jjdegaine/Wifi-Solar-panel-optimizer-/README.md

# Wifi-Solar-panel-optimizer-
Wifi solar panel optimizer
