jjdegaine/Wifi-Solar-panel-optimizer-/photos/electric box.jpg

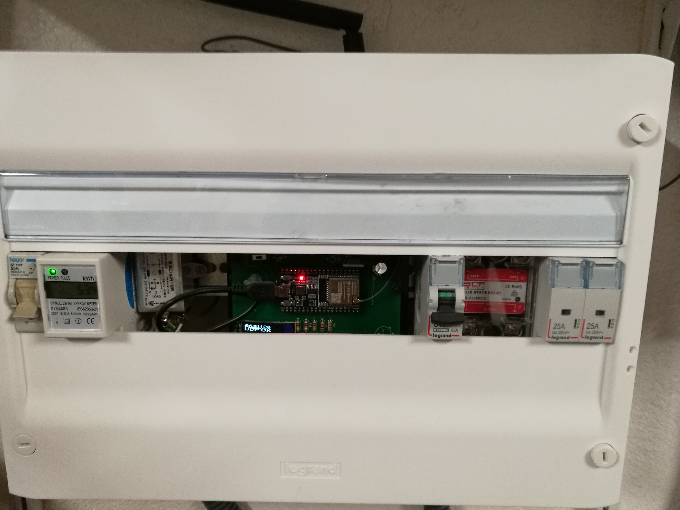
photos/electric box.jpg
