jjdegaine/Wifi-Solar-panel-optimizer-/photos/main board.jpg

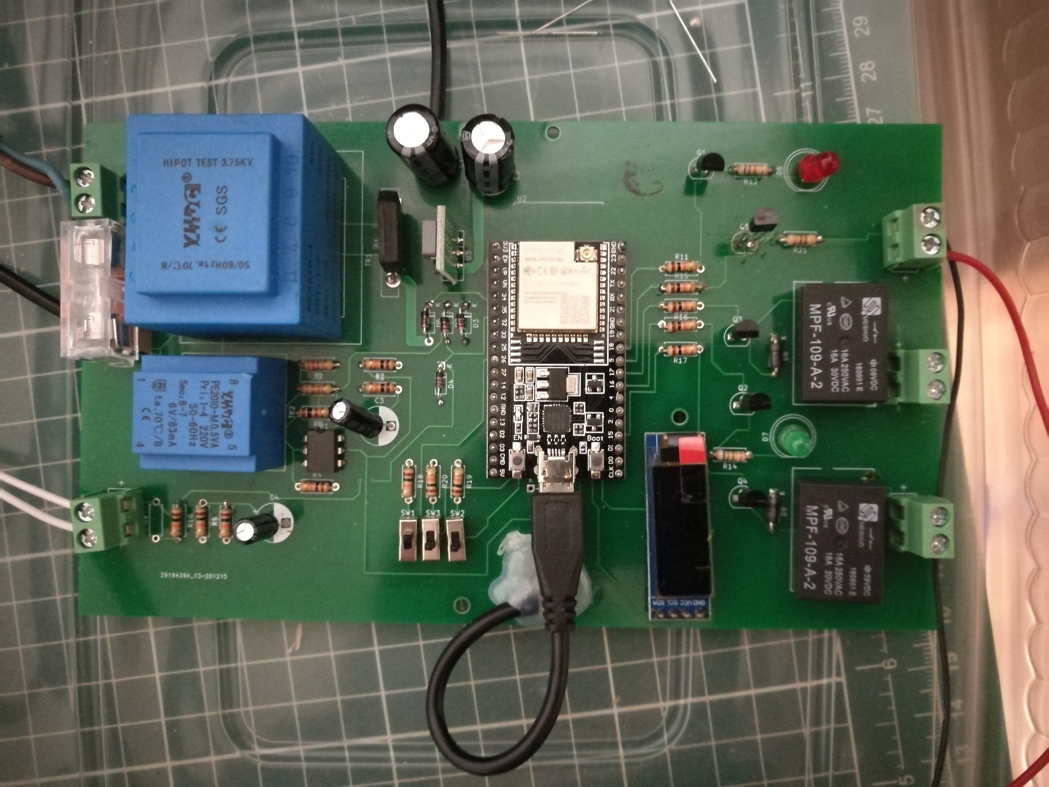
photos/main board.jpg
