jjdegaine/Wifi-Solar-panel-optimizer-/PCB/final version (not tested)/bom.xls

Date: | 19/04/2020 10:00:09
Tool: | Eeschema (5.1.5)-3
Component Count: | 58
Ref | Value | Footprint | Manufacturer
C1 | 1000uF 25V | Capacitor_THT:CP_Radial_D8.0mm_P5.00mm
C2 | 470uF 25V | Capacitor_THT:CP_Radial_D8.0mm_P5.00mm
C3 | 22uF 25V | Capacitor_THT:CP_Radial_D8.0mm_P5.00mm
C4 | 22uF 25V | Capacitor_THT:CP_Radial_D8.0mm_P5.00mm
D1 | GBU4A | Diode_THT:Diode_Bridge_ | https://fr.aliexpress.com/item/32337516440.html?spm=a2g0s.9042311.0.0.27426c37eJJ01N
D2 | 1N4148 | Diode_THT:D_DO-35_SOD27_P7.62mm_Horizontal
D3 | 1N4148 | Diode_THT:D_DO-35_SOD27_P7.62mm_Horizontal
D4 | 1N4148 | Diode_THT:D_DO-35_SOD27_P7.62mm_Horizontal
D5 | 1N4148 | Diode_THT:D_DO-35_SOD27_P7.62mm_Horizontal
D6 | LED RED | LED_THT:LED_D8.0mm
D7 | LED green | LED_THT:LED_D8.0mm
D8 | 1N4148 | Diode_THT:D_DO-35_SOD27_P7.62mm_Horizontal
D9 | 1N4148 | Diode_THT:D_DO-35_SOD27_P7.62mm_Horizontal
D10 | 1N4148 | Diode_THT:D_DO-35_SOD27_P7.62mm_Horizontal
F1 | Fuse | Fuse | https://fr.aliexpress.com/item/32693969111.html?spm=a2g0s.9042311.0.0.27426c37JHMXNt
J1 | Screw_Terminal_01x02 | MKDSN2.5/2-5.08 | https://www.tme.eu/fr/katalog/?search=MKDSN2.5%2F2-5.08&s_field=1000011&s_order=desc
J2 | Screw_Terminal_01x02 | MKDSN2.5/2-5.08 | https://www.tme.eu/fr/katalog/?search=MKDSN2.5%2F2-5.08&s_field=1000011&s_order=desc
J3 | Screw_Terminal_01x02 | MKDSN2.5/2-5.08 | https://www.tme.eu/fr/katalog/?search=MKDSN2.5%2F2-5.08&s_field=1000011&s_order=desc
J4 | Screw_Terminal_01x02 | MKDSN2.5/2-5.08 | https://www.tme.eu/fr/katalog/?search=MKDSN2.5%2F2-5.08&s_field=1000011&s_order=desc
J5 | Screw_Terminal_01x02 | MKDSN2.5/2-5.08 | https://www.tme.eu/fr/katalog/?search=MKDSN2.5%2F2-5.08&s_field=1000011&s_order=desc
J6 | Screw_Terminal_01x02 | MKDSN2.5/2-5.08 | https://www.tme.eu/fr/katalog/?search=MKDSN2.5%2F2-5.08&s_field=1000011&s_order=desc
J7 | Conn_01x04_Male | Connector_PinHeader_2.54mm:PinHeader_1x04_P2.54mm_Vertical
K1 | DIPxx-1Axx-MPF | Relay_THT:Relay_1-MPF109a2 | https://fr.aliexpress.com/item/33000315039.html?spm=a2g0s.9042311.0.0.27426c37eJJ01N
K2 | DIPxx-1Axx-MPF | Relay_THT:Relay_1-MPF109a2 | https://fr.aliexpress.com/item/33000315039.html?spm=a2g0s.9042311.0.0.27426c37eJJ01N
Q1 | Q_NPN_BCE | Package_TO_SOT_THT:TO-92_2n2222
Q2 | Q_NPN_BCE | Package_TO_SOT_THT:TO-92_2n2222
Q3 | Q_NPN_BCE | Package_TO_SOT_THT:TO-92_2n2222
Q4 | Q_NPN_BCE | Package_TO_SOT_THT:TO-92_2n2222
Q5 | Q_NPN_BCE | Package_TO_SOT_THT:TO-92_2n2222
R1 | 2.2k | Resistor_THT:R_Axial_DIN0207_L6.3mm_D2.5mm_P7.62mm_Horizontal
R2 | 10k | Resistor_THT:R_Axial_DIN0207_L6.3mm_D2.5mm_P7.62mm_Horizontal
R3 | 10k | Resistor_THT:R_Axial_DIN0207_L6.3mm_D2.5mm_P7.62mm_Horizontal
R4 | 10k | Resistor_THT:R_Axial_DIN0207_L6.3mm_D2.5mm_P7.62mm_Horizontal
R5 | 10k | Resistor_THT:R_Axial_DIN0207_L6.3mm_D2.5mm_P7.62mm_Horizontal
R6 | 10k | Resistor_THT:R_Axial_DIN0207_L6.3mm_D2.5mm_P7.62mm_Horizontal
R7 | 12k | Resistor_THT:R_Axial_DIN0207_L6.3mm_D2.5mm_P7.62mm_Horizontal
R8 | 1k | Resistor_THT:R_Axial_DIN0207_L6.3mm_D2.5mm_P7.62mm_Horizontal
R9 | R | Resistor_THT:R_Axial_DIN0207_L6.3mm_D2.5mm_P7.62mm_Horizontal | not used
R10 | 10k | Resistor_THT:R_Axial_DIN0207_L6.3mm_D2.5mm_P7.62mm_Horizontal
R11 | 10k | Resistor_THT:R_Axial_DIN0207_L6.3mm_D2.5mm_P7.62mm_Horizontal
R12 | 680 | Resistor_THT:R_Axial_DIN0207_L6.3mm_D2.5mm_P7.62mm_Horizontal
R13 | 10k | Resistor_THT:R_Axial_DIN0207_L6.3mm_D2.5mm_P7.62mm_Horizontal
R14 | 680 | Resistor_THT:R_Axial_DIN0207_L6.3mm_D2.5mm_P7.62mm_Horizontal
R15 | 10k | Resistor_THT:R_Axial_DIN0207_L6.3mm_D2.5mm_P7.62mm_Horizontal
R16 | 10k | Resistor_THT:R_Axial_DIN0207_L6.3mm_D2.5mm_P7.62mm_Horizontal
R17 | 10k | Resistor_THT:R_Axial_DIN0207_L6.3mm_D2.5mm_P7.62mm_Horizontal
R18 | 10k | Resistor_THT:R_Axial_DIN0207_L6.3mm_D2.5mm_P7.62mm_Horizontal
R19 | 10k | Resistor_THT:R_Axial_DIN0207_L6.3mm_D2.5mm_P7.62mm_Horizontal
R20 | 10k | Resistor_THT:R_Axial_DIN0207_L6.3mm_D2.5mm_P7.62mm_Horizontal
R21 | 410ohm | Resistor_THT:R_Axial_DIN0207_L6.3mm_D2.5mm_P7.62mm_Horizontal
SW1 | SW_SPDT | Connector_PinHeader_2.54mm:PinHeader_1x03_P2.54mm_Vertical | https://fr.aliexpress.com/item/32799198160.html?spm=a2g0s.9042311.0.0.27426c3767edjO
SW2 | SW_SPDT | Connector_PinHeader_2.54mm:PinHeader_1x03_P2.54mm_Vertical | https://fr.aliexpress.com/item/32799198160.html?spm=a2g0s.9042311.0.0.27426c3767edjO
SW3 | SW_SPDT | Connector_PinHeader_2.54mm:PinHeader_1x03_P2.54mm_Vertical | https://fr.aliexpress.com/item/32799198160.html?spm=a2g0s.9042311.0.0.27426c3767edjO
TR1 | TEZ6.0-D-1 | Transformer_THT:Transformer_PE3518-I | https://fr.aliexpress.com/item/32751030975.html?spm=a2g0s.9042311.0.0.27426c372HA4Ji
TR2 | TEZ0.5-D-1 | Transformer_THT:Transformer_Breve_TEZ-22x24 | https://fr.aliexpress.com/item/32735752858.html?spm=a2g0s.12269583.0.0.718020ecdFrNoO
U1 | H11AA1 | Package_DIP:DIP-6_W7.62mm | https://fr.aliexpress.com/item/33047446272.html?spm=a2g0s.9042311.0.0.27426c37DKziA6
U2 | ESP32-WROOM-32U_DEVKIT | RF_Module:ESP32-WROOM-32Udevkit
U3 | LM7805_TO220 | Package_TO_SOT_THT:TO-220-3_Vertical | https://fr.aliexpress.com/item/33009365888.html?spm=a2g0s.9042311.0.0.27426c37DKziA6
current sensor |  |  | https://fr.aliexpress.com/item/32770348773.html?spm=a2g0s.9042311.0.0.27426c376V7s30
SSR |  |  | SSR-2528RD3 Relay
