jjdegaine/Wifi-Solar-panel-optimizer-/PCB/final version (not tested)/placement.pdf

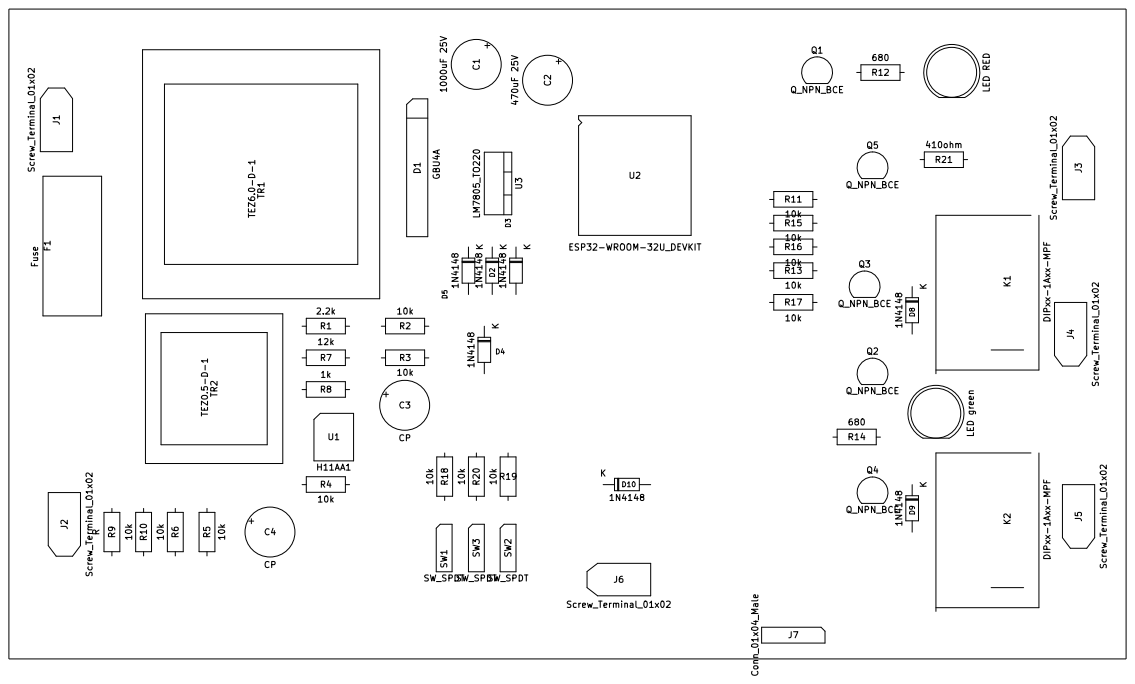
[picture p13: page 1]
