jjdegaine/Wifi-Solar-panel-optimizer-/PCB/final version (not tested)/scheme.pdf

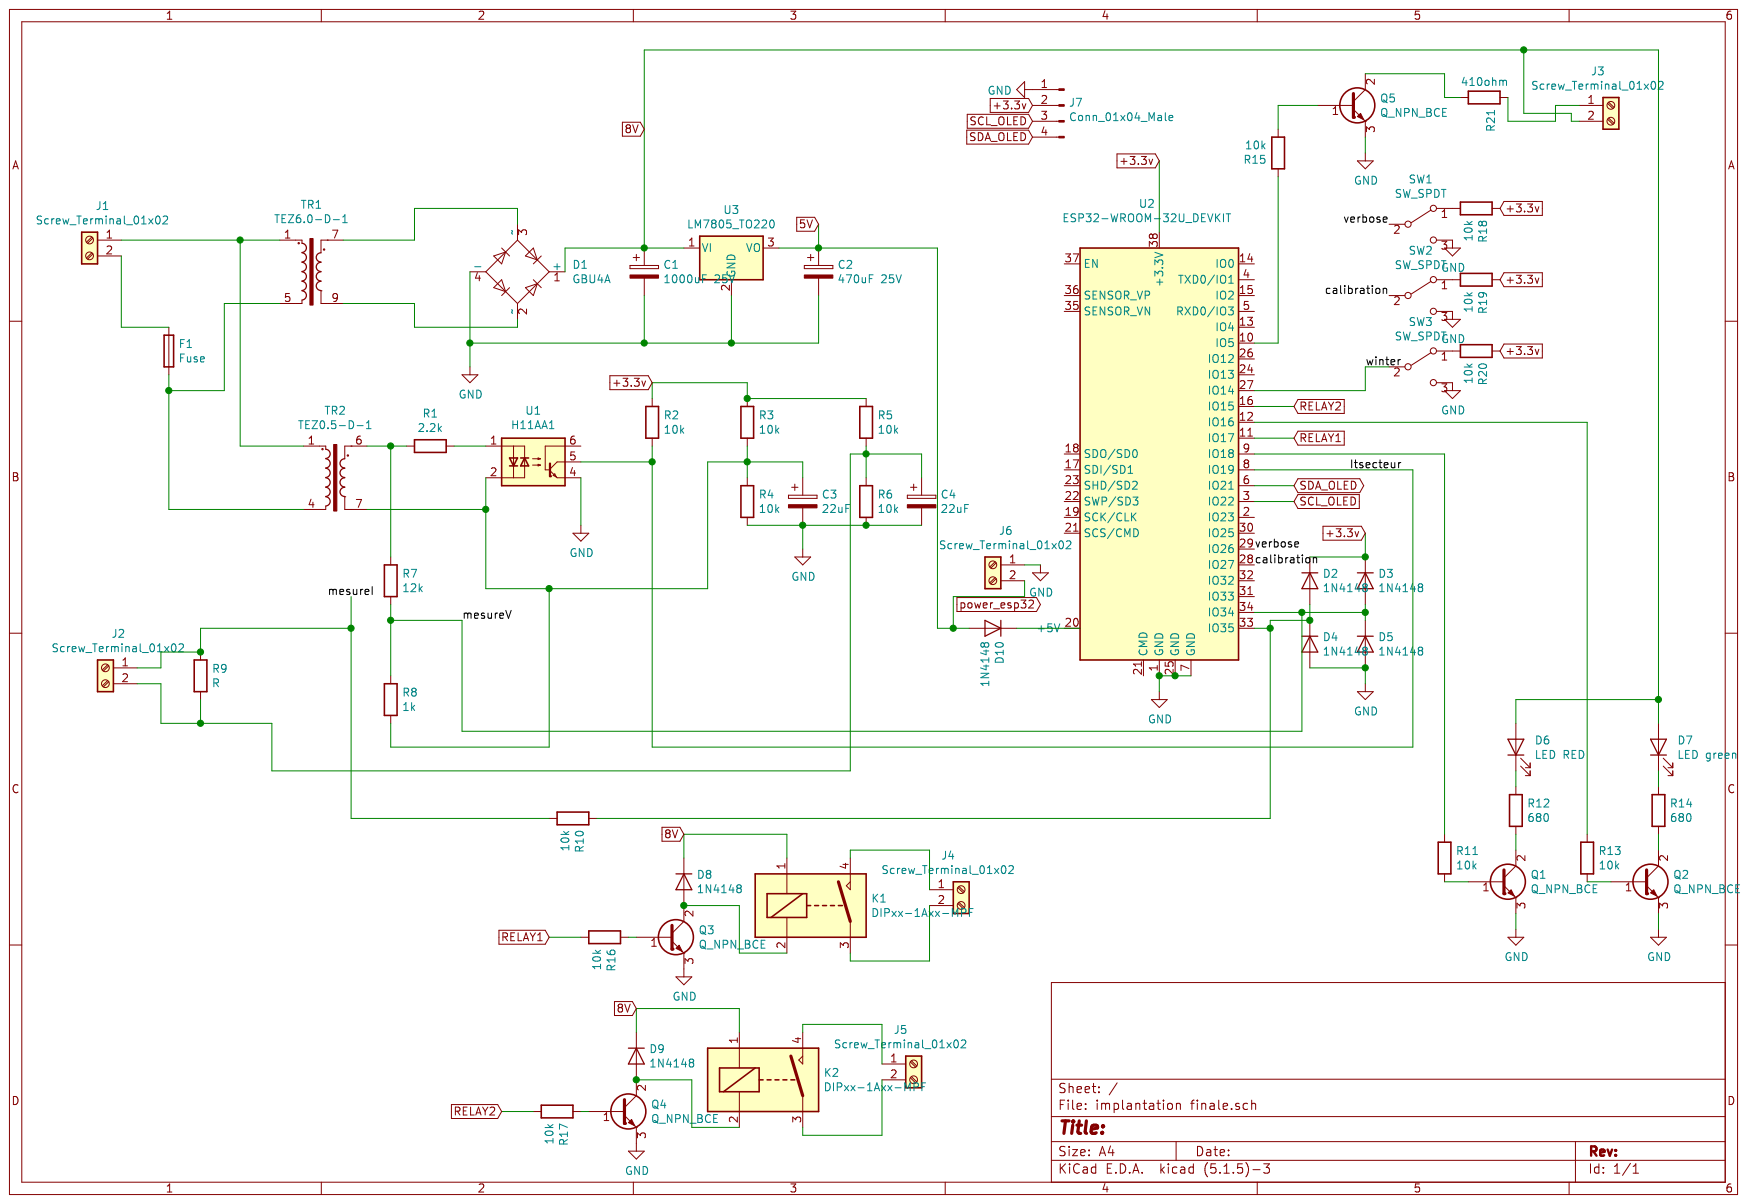
[picture p14: page 1]
