jjdegaine/Wifi-Solar-panel-optimizer-/PCB/final version (not tested)/tracks bottom.pdf

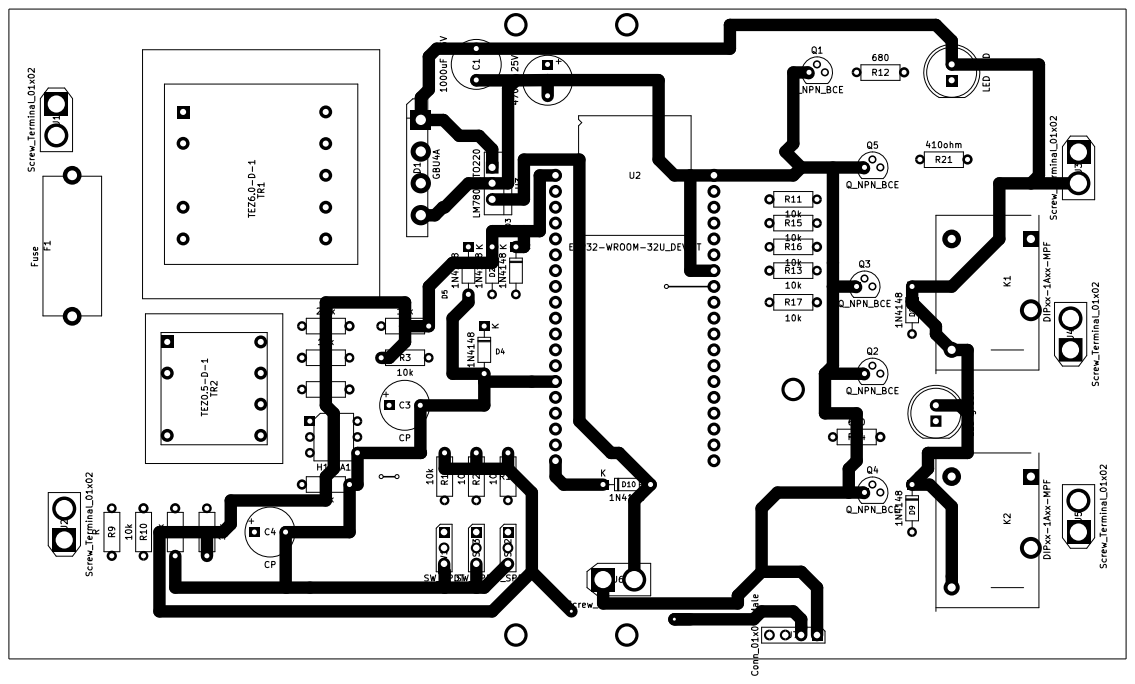
[picture p15: page 1]
