jjdegaine/Wifi-Solar-panel-optimizer-/PCB/final version (not tested)/tracks top.pdf

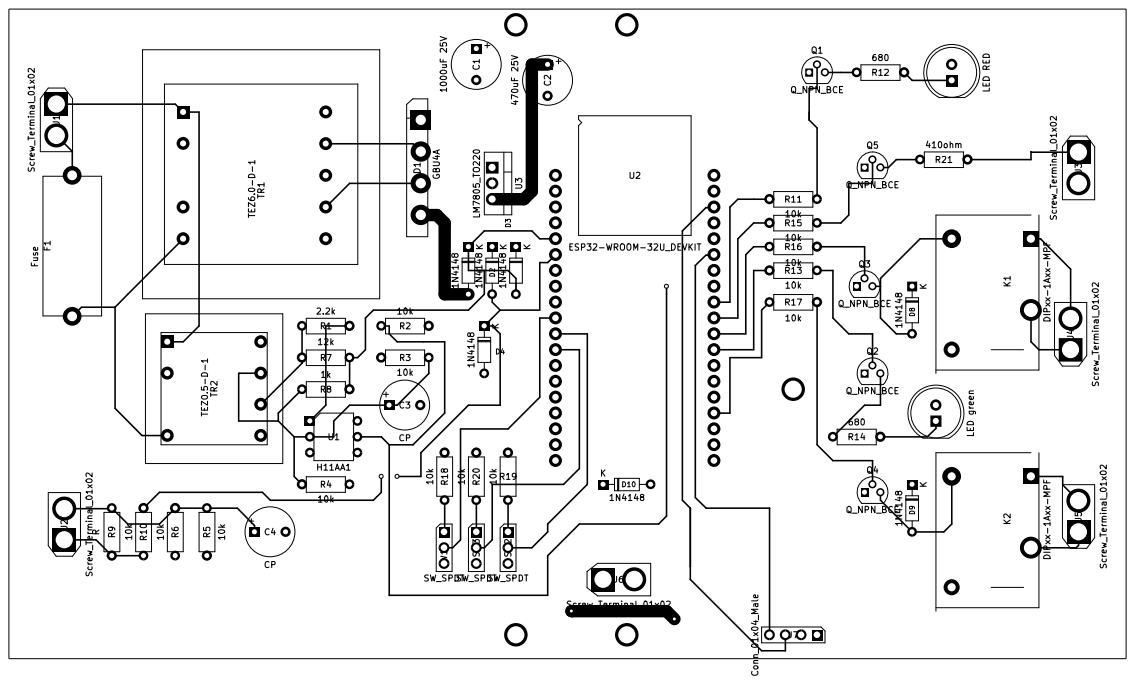
[picture p16: page 1]
