jjdegaine/Wifi-Solar-panel-optimizer-/PCB/old version/tracks bottom.pdf

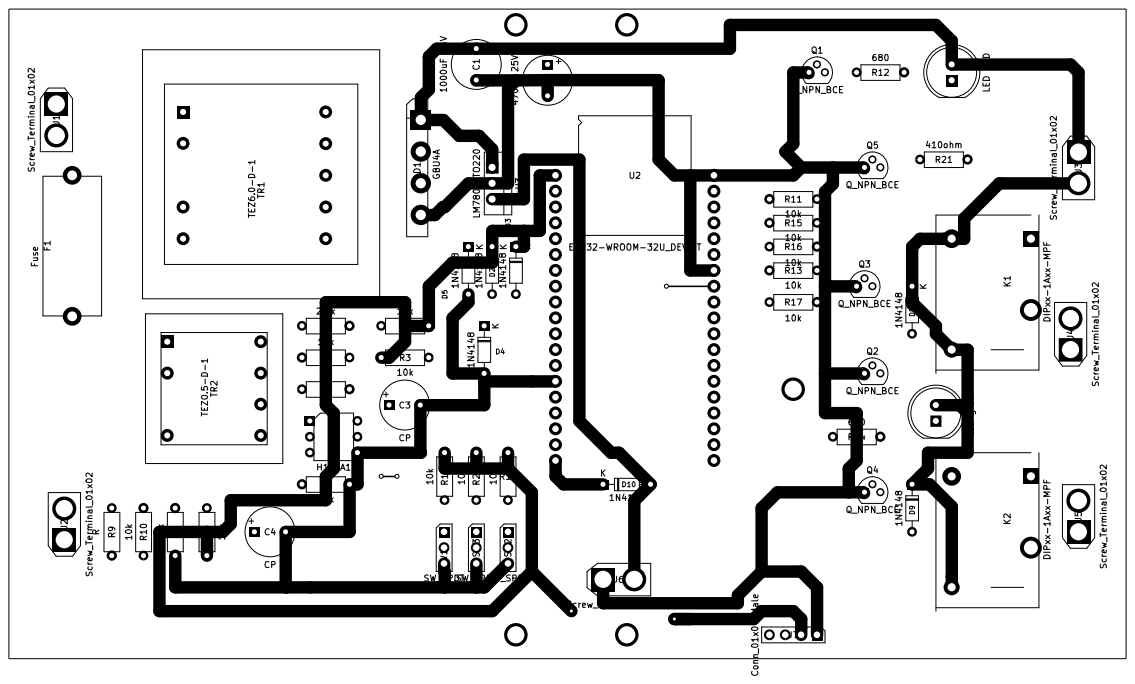
[picture p17: page 1]
